KuchTo/Codelock/Codeschloss_Teil_2_Steckplatine.jpg

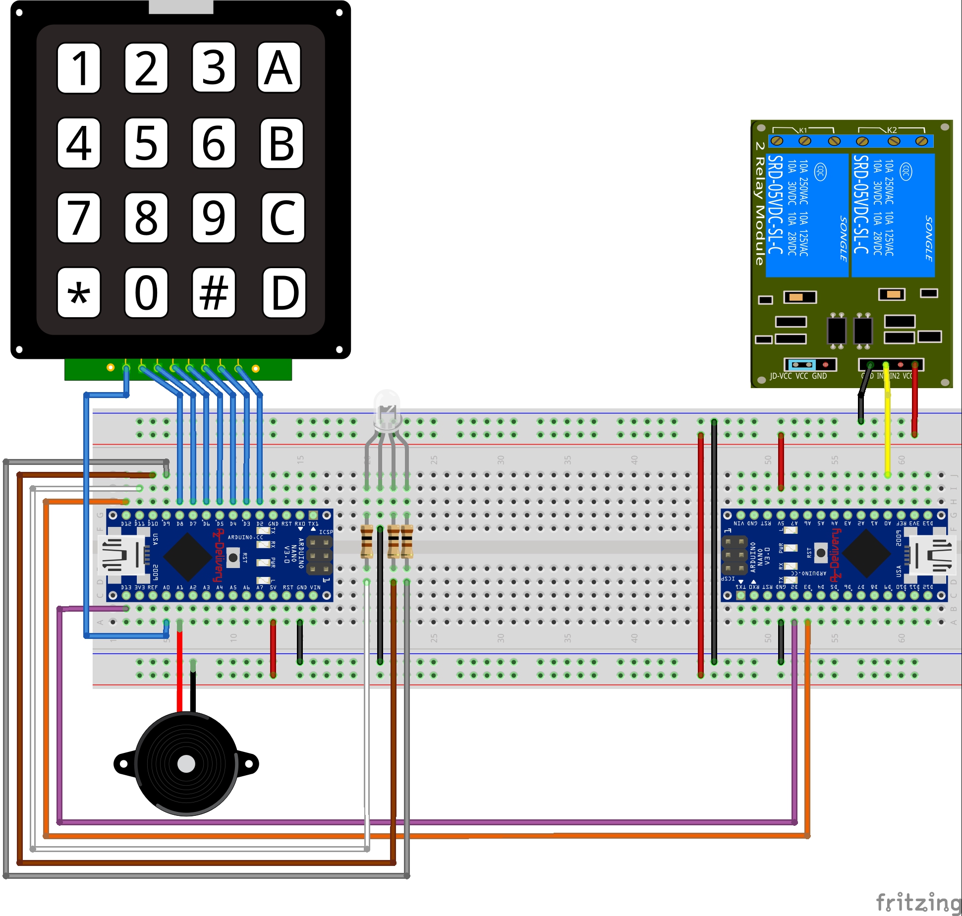
Codeschloss_Teil_2_Steckplatine.jpg
