KuchTo/Codelock/README.md

# Codelock
Codeschloss mit Netzwerkanbindung
