KuchTo/Codelock/Codeschloss_Teil_4_Steckplatine.jpg

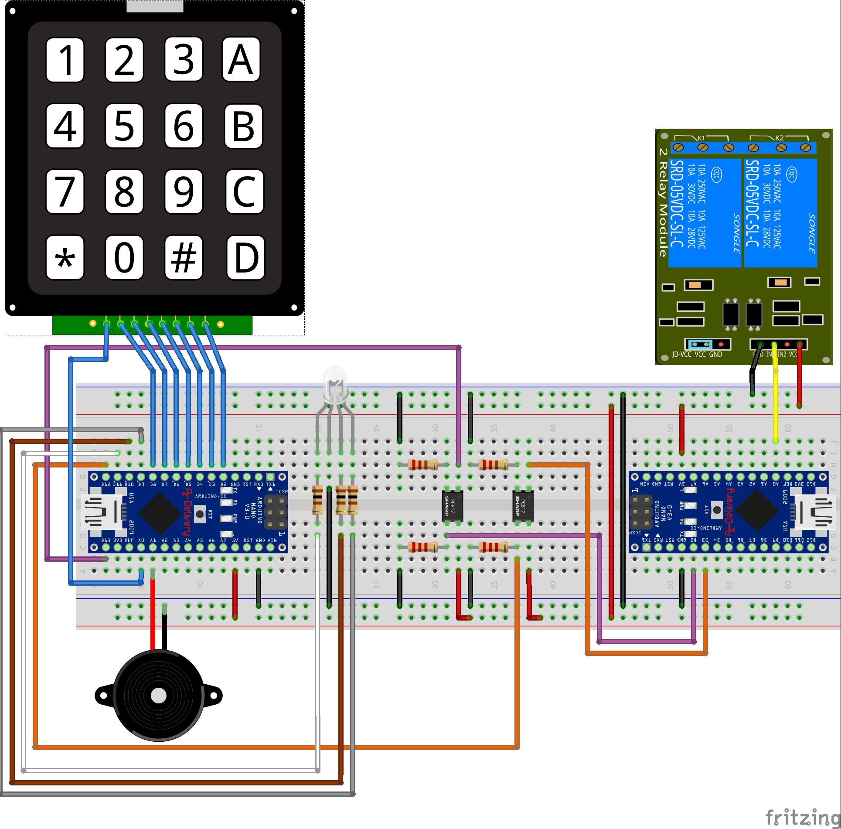
Codeschloss_Teil_4_Steckplatine.jpg
