KuchTo/Codelock/(threads)

Thread 1 (2021-05-29):

Code für Controller A in Teil 2 identisch mit Teil 3

Schwefelholz, 2021-05-29:
Hallo,

ich bin eben darüber gestolpert, dass ich Teil 2 des Codeschloss-Projekts nicht zum Laufen bekommen habe. Ein Debugging der seriellen Übertragung brachte mich dann darauf, dass Controller A die Eingabe verschlüsselt an Controller B schickt, dieser aber nicht entschlüsselt.
Wenn ich das richtig sehe, ist die Verschlüsselung erst in Teil 3 geplant. Und ein diff des Codes für Controller A in Teil 2 und Teil 3 zeigt tatsächlich keine Unterschiede...

VG
Thomas
