KuchTo/Codelock/(list of files, drawings)

Other design files:
Codeschloss_Teil_1.fzz
Codeschloss_Teil_2.fzz
Codeschloss_Teil_3.fzz
Codeschloss_Teil_4.fzz
Codeschloss_Teil_5.fzz
Codeschloss_Teil_6.fzz
