KuchTo/Codelock/(commit log)

2020-06-19 Add files via upload
    Fritzing Files Schaltungsschema
    [Codeschloss_Teil_1.fzz, Codeschloss_Teil_2.fzz, Codeschloss_Teil_3.fzz, Codeschloss_Teil_4.fzz, Codeschloss_Teil_5.fzz]
2020-06-19 Add files via upload
    Arduino IDE Quellcode
